Pakequis/Raspberry-pi-TV-sim/(threads)

Thread 1 (2022-06-22):

Possible improvements

jonshouse1, 2022-06-22:
It may be possible to remove both the relay and the Arduino

This describes how to crudely read a POT using PWM, 2 resistors and a capacitor
https://www.circuitbasics.com/using-potentiometers-with-raspberry-pi/

You could remove the relay board and play the "TV static" as a video clip.

Using fork() you may be able to start one clip playing before the previous has finished, that might cure the framebuffer showing issue.
or failing that try adding something like "cp /dev/zero /dev/fb0" to blank the framebuffer.

Closed 2022-09-20.
