Pakequis/Raspberry-pi-TV-sim/(commit log)

2022-06-20 Relay board schematic correction
2022-06-30 relay board image fix
